als0052/py-PiPrinter/all_the_pi/Documents/Images/board_wiring_3.jpg

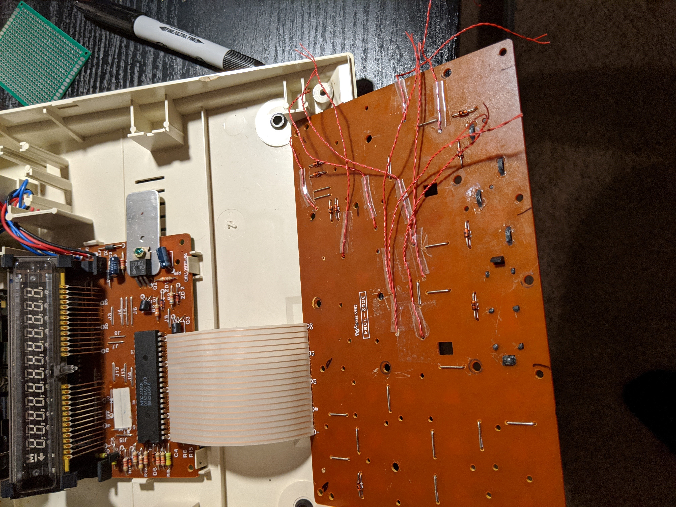
all_the_pi/Documents/Images/board_wiring_3.jpg
