als0052/py-PiPrinter/all_the_pi/Documents/Electrical/mmc_hardware_parts.txt

McMaster Carr
https://www.mcmaster.com/95185A110
https://www.mcmaster.com/93505A101

Amazon
https://www.amazon.com/Hakko-FX888D29BY-ESD-Safe-Digital-Soldering/dp/B00OSM27T8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
https://www.amazon.com/QuadHands-Helping-Hands-Third-Soldering/dp/B00GIKVP5K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
https://www.amazon.com/MAIYUM-63-37-Solder-Electrical-Soldering/dp/B076QF1Y85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

https://www.amazon.com/Adding-Machine-Calculator-White-UNV35715/dp/B0002A5AVM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
https://www.amazon.com/Compatible-Nukote-Calculator-Ribbon-6-pack/dp/B0057KY2Y8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
