als0052/py-PiPrinter/all_the_pi/Documents/Electrical/keyboard_IC_pinouts.xlsx

Sheet: Sheet1
pin | Pin symbol | port
1 | RESET | reset
2 | CL1 | CLOCK PIN 1
3 | CL2 | CLOCK PIN 2
4 | V_pre | high voltage predriver supply
5 | V_LOAD | high voltage optin resistor supply 7527A/28A only
6 | P5_0 | high voltage i/o port 5_0
7 | P5_1 | high voltage i/o port 5_1
8 | P5_2 | high voltage i/o port 5_2
9 | P5_3 | high voltage i/o port 5_3
10 | P2_3 | high voltage output port 2_3 and output port from timer/event counter (ptout)
11 | P2_2 | high voltage output port 2_2 and output port from timer/event counter (ptout)
12 | P2_1/PTOUT | high voltage output port 2_1 and output port from timer/event counter (ptout)
13 | P0_0 | high current high voltage i/o port 0_0
14 | P0_1 | high current high voltage i/o port 0_1
15 | P0_2 | high current high voltage i/o port 0_2
16 | P0_3 | high current high voltage i/o port 0_3
17 | P1_0 | high current high voltage i/o port 1_0
18 | P1_1 | high current high voltage i/o port 1_1
19 | P1_2 | high current high voltage i/o port 1_2
20 | P1_3 | high current high voltage i/o port 1_3
21 | V_DD | positive power supply
22 | P9_0 | high voltage high-current output port 9_0
23 | P9_1 | high voltage high-current output port 9_1
24 | P9_2 | high voltage high-current output port 9_2
25 | P9_3 | high voltage high-current output port 9_3
26 | P8_0 | high voltage high current output port 8_0
27 | P8_1 | high voltage high current output port 8_1
28 | P8_2 | high voltage high current output port 8_2
29 | P8_3 | high voltage high current output port 8_3
30 | P4_0 | high voltage i/o port 4_0
31 | P4_1 | high voltage i/o port 4_1
32 | P4_2 | high voltage i/o port 4_2
33 | P4_3 | high voltage i/o port 4_3
34 | P3_0 | high voltage output port 3_0
35 | P3_1 | high voltage output port 3_1
36 | P3_2 | high voltage output port 3_2
37 | P3_3 | high voltage output port 3_3
38 | P0_3/SI | 4 bit input of port 0; or serial data input (SI), serial data output (SO), serial clock 1/0 (SCK), and external interrupt input (INTO) or zero-cross detect input (PO_o)
39 | P0_2/SO | 4 bit input of port 0; or serial data input (SI), serial data output (SO), serial clock 1/0 (SCK), and external interrupt input (INTO) or zero-cross detect input (PO_o)
40 | P0_1/SCK | 4 bit input of port 0; or serial data input (SI), serial data output (SO), serial clock 1/0 (SCK), and external interrupt input (INTO) or zero-cross detect input (PO_o)
41 | P0_0/INTO | 4 bit input of port 0; or serial data input (SI), serial data output (SO), serial clock 1/0 (SCK), and external interrupt input (INTO) or zero-cross detect input (PO_o)
42 | V_SS | Ground

Sheet: Sheet2
Port Name | Description
RESET | system reset (input)
CL1, CL2 | connection to RC oscillator. CL1 is the external clock input
V_PRE | negative power supply for high-voltage output pre-drivers (ports 2-5, 8-11)
V_LOAD | negative power supply for optional load desistors (pull-down resistors) of high voltage output drivers (ports 2-5, 8-11). This pin is only on the PD7527A/28A
P5_3-P5_0 | 4-bit high voltage I/O port 5
P2_1-P2_3 | 3-bit high voltage output port 2
PTOUT | Output port from the timer/event counter
P10_3-P10_0 | 4-bit, high voltage, high-current I/O port 10. Capable of bit set/reset by SPBL/RPBL instructions
P11_3-P11_0 | 4-bit, high voltage, high-current I/O port 11. Capable of bit set/reset by SPBL/RPBL instructions
V_DD | positive power supply
P9_3-P9_0 | 4-bit high voltage high current output port 9. Capable of bit set/reset by SPBL/RPBL instructions.
P8_3-P8_0 | 4-bit high voltage high current output port 8. Capable of bit set/reset by SPBL/RPBL instructions.
P4_3-P4_0 | 4-bit high voltage I/O port 4
P3_3-P3_0 | 4-bit high voltage I/O port 3
P0_3-P0_0 | 4-bit input port 0. P0_0 is also used as the zero-cross detection input.
SI | serial data input
SO | serial data output
SCK | I/O serial clock
INT0 | external interrupt input
V_SS | ground
