als0052/py-PiPrinter/all_the_pi/Documents/Electrical/schemeit-project.png

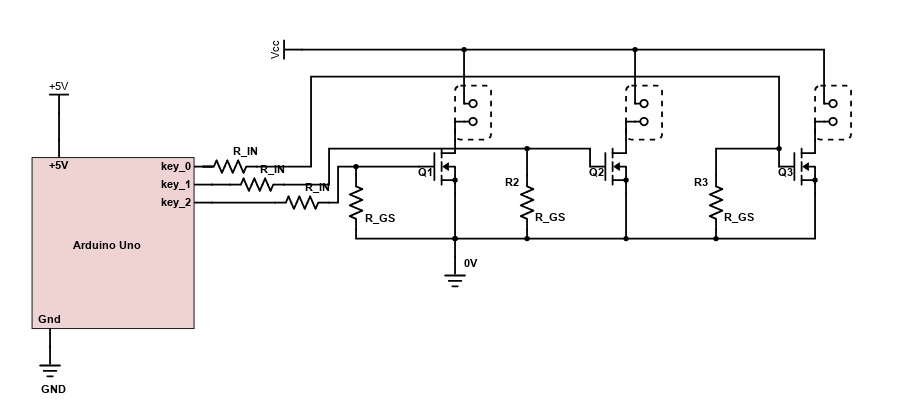
all_the_pi/Documents/Electrical/schemeit-project.png
