als0052/py-PiPrinter/all_the_pi/Documents/powerpoint_is_useful.png

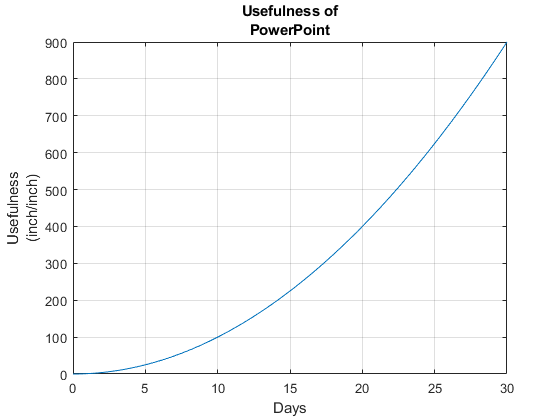
all_the_pi/Documents/powerpoint_is_useful.png
