als0052/py-PiPrinter/all_the_pi/Documents/Electrical/Master BOM.xlsx

Sheet: Summary
 | Total | $114.91
id | Vendor | Subtotal
1 | Digikey | $33.58
2 | McMaster Carr | $21.79
3 | Amazon | $59.54
4
5
6
7
8
9
10
11
12
13
14
15
16
17
18
19
20
21
22
23
24
25

Sheet: Digikey
Index | Quantity | Part Number | Manufacturer Part Number | Description | Customer Reference | Available | Backorder | Unit Price | Extended Price USD
1 | 10 | ED10503-ND | 101-206 | CONN SOCKET 20POS IDC GOLD |  | 10 | 0 | $0.41 | $4.13
2 | 10 | ED10524-ND | 302-S201 | CONN HEADER VERT 20POS 2.54MM |  | 10 | 0 | $0.45 | $4.48
3 | 0 | 2057-PH2-20-UA-ND | PH2-20-UA | CONN HEADER VERT 20POS 2.54MM |  | 10 | 0 | $0.25 | $0.00
4 | 0 | WM19417-ND | 14441202 | CONN PLUG 2POS IDC 24AWG GOLD |  | 10 | 0 | $0.66 | $0.00
5 | 2 | 2183-4000-ND | 4000 | POLOLU 400-POINT BREADBOARD WITH |  | 5 | 0 | $2.55 | $5.10
6 | 0 | ED10565-ND | OSTVN06A150 | TERM BLK 6P SIDE ENT 2.54MM PCB |  | 1 | 0 | $1.77 | $0.00
7 | 0 | ED10567-ND | OSTVN10A150 | TERM BLK 10P SIDE ENT 2.54MM PCB |  | 1 | 0 | $2.95 | $0.00
8 | 0 | ED10566-ND | OSTVN08A150 | TERM BLK 8P SIDE ENT 2.54MM PCB |  | 2 | 0 | $2.36 | $0.00
9 | 0 | 952-1902-ND | M20-9992046 | CONN HEADER VERT 20POS 2.54MM |  | 20 | 0 | $0.59 | $0.00
10 | 0 | DW-10-07-G-S-200-ND | DW-10-07-G-S-200 | CONN HDR 10POS 0.1 STACK T/H |  | 4 | 0 | $1.24 | $0.00
11 | 2 | CP3-1000-ND | PP3-002A | CONN PWR PLUG 2.1X5.5MM SOLDER |  | 2 | 0 | $1.29 | $2.58
12 | 0 | K229-ND | R-30B-0050 | WIRE WW 30AWG PVDF BLUE 50' |  | 1 | 0 | $10.50 | $0.00
13 | 0 | K231-ND | R-30W-0050 | WIRE WW 30AWG PVDF WHITE 50' |  | 1 | 0 | $10.50 | $0.00
14 | 0 | K232-ND | R-30R-0050 | WIRE WW 30AWG PVDF RED 50' |  | 1 | 0 | $10.50 | $0.00
15 | 0 | K230-ND | R-30Y-0050 | WIRE WW 30AWG PVDF YELLOW 50' |  | 1 | 0 | $10.50 | $0.00
16 | 0 | K397-ND | R30W-0100 | WIRE WW 30AWG PVDF WHITE 100' |  | 1 | 0 | $13.40 | $0.00
17 | 0 | K394-ND | R30BLK-0100 | WIRE WW 30AWG PVDF BLACK 100' |  | 1 | 0 | $13.40 | $0.00
18 | 0 | C503B-RAN-CZ0C0AA1-ND | C503B-RAN-CZ0C0AA1 | LED RED CLEAR 5MM ROUND T/H |  | 1 | 0 | $0.15 | $0.00
19 | 1 | HDM24H-ND | AWLP 24/3,2-G | CONN DIP HDR IDC 24POS VERT |  | 1 | 0 | $1.35 | $1.35
20 | 1 | WM9685-ND | 873690400 | CONN RCPT HSG 4POS 2.00MM |  | 1 | 0 | $0.10 | $0.10
21 | 100 | WM4561CT-ND | 502128000 | CONN SOCKET 24-30AWG CRIMP TIN |  | 100 | 0 | $0.04 | $4.15
22 | 1 | WM13310-ND | 894010410 | CONN HEADER R/A 4POS 2MM |  | 1 | 0 | $0.16 | $0.16
23 | 10 | A1922-ND | 640456-4 | CONN HEADER VERT 4POS 2.54MM |  | 10 | 0 | $0.21 | $2.14
24 | 10 | A30980-ND | 3-640441-4 | CONN RCPT 4POS IDC 24AWG TIN |  | 10 | 0 | $0.20 | $2.02
25 | 100 | A24745CT-ND | 42068 | CONN QC RCPT 18-22AWG 0.110 |  | 100 | 0 | $0.06 | $5.88
26 | 1 | EG4539-ND | MS0850501F025C1A | SWITCH SNAP ACTION SPDT 5A 125V |  | 1 | 0 | $1.49 | $1.49

Sheet: MMC
id | Order Qty | Qty/order | P/N | Description | Price | Cost | Link
1 | 1 | 50 | 95185A110 | Zinc-Plated Steel Press-Fit Nut for Sheet Metal 4-40 Thread Size, for 0.03" Minimum Panel Thickness | $10.60 | $10.60 | link (https://www.mcmaster.com/95185A110)
2 | 10 | 1 | 93505A101 | Male-Female Threaded Hex Standoff Aluminum, 3/16" Hex Size, 1/4" Long, 4-40 Thread Size | $0.36 | $3.60 | link (https://www.mcmaster.com/93505A101)
3 | 0 | 100 | 94639A703 | Off-White Nylon Unthreaded Spacer 3/16" OD, 3/16" Long, for Number 2 Screw Size | $9.24 | $0.00 | link (https://www.mcmaster.com/94639a703)
4 | 0 | 50 | 91831A002 | 18-8 Stainless Steel Nylon-Insert Locknut 2-56 Thread Size | $3.95 | $0.00 | link (https://www.mcmaster.com/91831a002)
5 | 0 | 25 | 96439A130 | 18-8 Stainless Steel Press-Fit Nut for Sheet Metal 2-56 Thread Size, for 0.025" Minimum Panel Thickness | $8.02 | $0.00 | link (https://www.mcmaster.com/96439a130)
6 | 0 | 100 | 90480A003 | Low-Strength Steel Hex Nut Zinc-Plated, 2-56 Thread Size | $1.00 | $0.00 | link (https://www.mcmaster.com/90480A003)
7 | 0 | 50 | 91251A055 | Black-Oxide Alloy Steel Socket Head Screw 0-80 Thread Size, 1/4" Long | $3.54 | $0.00 | LINK (https://www.mcmaster.com/91251a055)
8 | 0 | 100 | 90480A001 | Low-Strength Steel Hex Nut Zinc-Plated, 0-80 Thread Size | $5.02 | $0.00 | link (https://www.mcmaster.com/90480A001)
9 | 0 | 1 | 6338K564 | Oil-Embedded Flanged Sleeve Bearing for 3/16" Shaft Diameter and 5/16" Housing ID, 3/8" Long | $0.70 | $0.00 | link (https://www.mcmaster.com/6338k564)
10 | 0 | 1 | 1327K105 | Rotary Shaft 12L14 Carbon Steel, 3/16" Diameter, 5" Long | $4.56 | $0.00 | link (https://www.mcmaster.com/1327k105)
11 | 1 | 100 | 91737A069 | Narrow Fillister Head Phillips Screws High-Profile, 4-40 Thread, 3/16" Long | $4.22 | $4.22 | link (https://www.mcmaster.com/91737a069)
12 | 1 | 100 | 90730A005 | 18-8 Stainless Steel Narrow Hex Nut 4-40 Thread Size | $3.37 | $3.37 | link (https://www.mcmaster.com/90730a005)
13
14
15
16
17
18
19
20
21
22
23
24
25

Sheet: Amazon
id | Order Qty | Qty/order | P/N | Description | Price | Cost | Link
1 | 0 | 1 | FX888D-29BY/P | Hakko FX888D29BY/P ESD-Safe Digital Soldering Station w/ FX8801 Soldering Iron and T18D16 Tip (Gold) | $104.95 | $0.00 | link (https://www.amazon.com/Hakko-FX888D29BY-ESD-Safe-Digital-Soldering/dp/B00OSM27T8)
2 | 0 | 1 |  | QuadHands Helping Hands Soldering Third Hand Tool | 4 Flexible Metal Arms Are Easy to Position | Rotating Stainless Steel Clamps | Made in USA - Professional Grade | $39.95 | $0.00 | link (https://www.amazon.com/QuadHands-Helping-Hands-Third-Soldering/dp/B00GIKVP5K)
3 | 1 | 1 |  | MAIYUM 63-37 Tin Lead Rosin core solder wire for electrical soldering (0.6mm 100g) | $9.59 | $9.59 | link (https://www.amazon.com/gp/product/B076QD1W9X/ref=ox_sc_act_title_2?smid=A25N4YN27ERTBB&psc=1)
4 | 0 | 12 |  | Adding Machine/Calculator Roll, 2-1/4"x150 ft White 12/Pack, UNV35715 | $10.99 | $0.00 | link (https://www.amazon.com/Adding-Machine-Calculator-White-UNV35715/dp/B0002A5AVM)
5 | 0 | 6 |  | New Compatible Nukote BR80C Calculator Ribbon Black/Red (6-pack) For Sharp El 1197 P III | $7.01 | $0.00 | link (https://www.amazon.com/Compatible-Nukote-Calculator-Ribbon-6-pack/dp/B0057KY2Y8)
6 | 0 | 1280 | An-resistor01 | 1280 Pieces 64 Values Resistor Kit, 1% Assorted Resistors 1 Ohm-10M Ohm 1/4W Metal Film Resistors Assortment with Storage Box for DIY Projects and Experiments | $13.99 | $0.00 | link (https://www.amazon.com/Resistor-Assorted-Resistors-Assortment-Experiments/dp/B07L851T3V)
7 | 1 | 5 |  | HiLetgo 5pcs Micro SD TF Card Adater Reader Module 6Pin SPI Interface Driver Module with chip Level Conversion for Arduino UNO R3 MEGA 2560 Due | $6.99 | $6.99 | link (https://www.amazon.com/gp/product/B07BJ2P6X6/ref=ox_sc_saved_title_1?smid=A30QSGOJR8LMXA&psc=1)
8 | 1 | 1 |  | SanDisk Ultra 32GB MicroSDHC UHS-I Card with Adapter - 98MB/s U1 A1 - SDSQUAR-032G-GN6MA | $7.99 | $7.99 | link (https://www.amazon.com/gp/product/B073JWXGNT/ref=ox_sc_saved_title_2?smid=ATVPDKIKX0DER&psc=1)
9 | 2 | 10 |  | BOJACK RFP30N06LE MOSFET 30 A 60 V RFP30N06LE N-Channel Power MOSFET Transistor ESD Rated TO-220 (Pack of 10 Pcs) | $7.99 | $15.98 | link (https://www.amazon.com/BOJACK-RFP30N06LE-MOSFET-N-Channel-Transistor/dp/B07WR86ZGS)
10 | 1 | 1 |  | DOWELL Wire Stripper with Cutter Wire Stripping Tool 10-24AWG for Flat Ribbon Cable Wire Electrical Automotive Repair | $9.99 | $9.99 | link (https://www.amazon.com/gp/product/B07HF2SGHX/ref=ox_sc_act_title_7?smid=ATB7GMXHTWNOH&psc=1)
11 | 1 | 1 |  | KNACRO Arduino Compatible Prototyping Board PCB Bare Board Universal Extension Boardproto Screw Shield | $9.00 | $9.00 | link (https://www.amazon.com/KNACRO-compatible-Prototyping-Universal-Boardproto/dp/B0716NB1VS)
12
13
14
15
16
17
18
19
20
21
22
23
24
25
