als0052/py-PiPrinter/all_the_pi/Documents/SCAD/PaperSpoolMaker.3mf

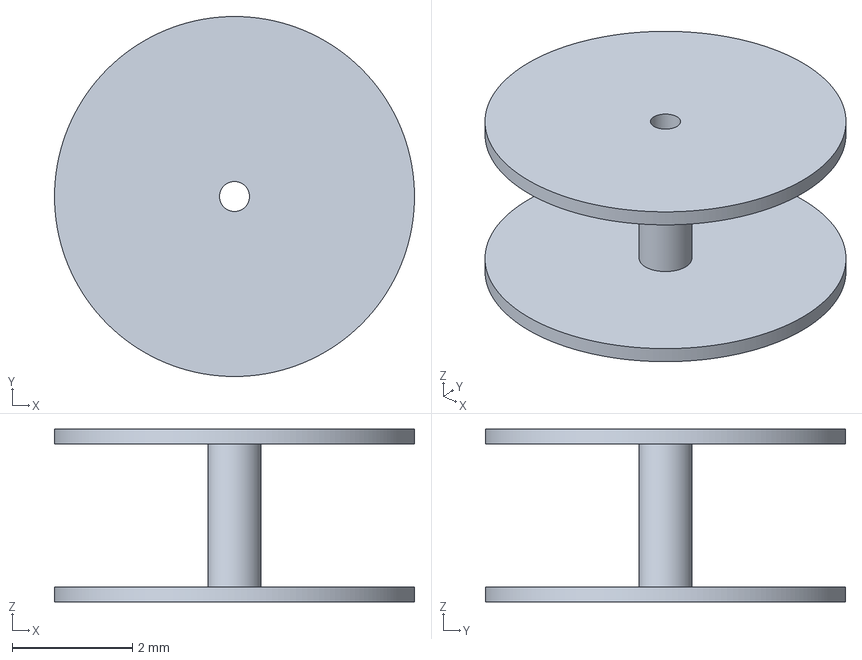
[picture p5: CAD file, 2021-02-16]
all_the_pi/Documents/SCAD/PaperSpoolMaker.3mf
6.00 x 6.00 x 2.88 mm
