als0052/py-PiPrinter/all_the_pi/Documents/Electrical/PiPrinter_Rev9.pdf

U1

## SD Card Module

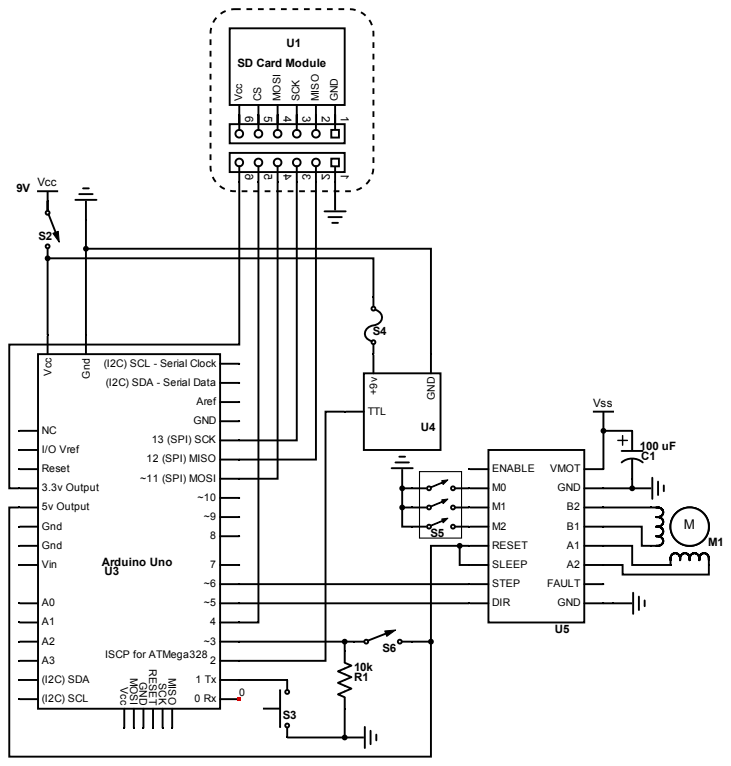
[picture p6: page 1]
Vcc; OSI; SCK; MISO; GND; Vcc 9V; Vss; VMOT; FAULT; ENABLE; RESET; SLEEP; STEP; DIR; TTL; ISCP for ATMega328; Gnd; I/O Vref; Reset; 3.3v Output; 5v Output; Vin; (I2C) SDA; (I2C) SCL; Aref; 13 (SPI) SCK; 12 (SPI) MISO; ~11 (SPI) MOSI; MISO SCK; M OSI Vcc; Arduino Uno U3

(I2C) SCL - Serial Clock
(I2C) SDA - Serial Data

M

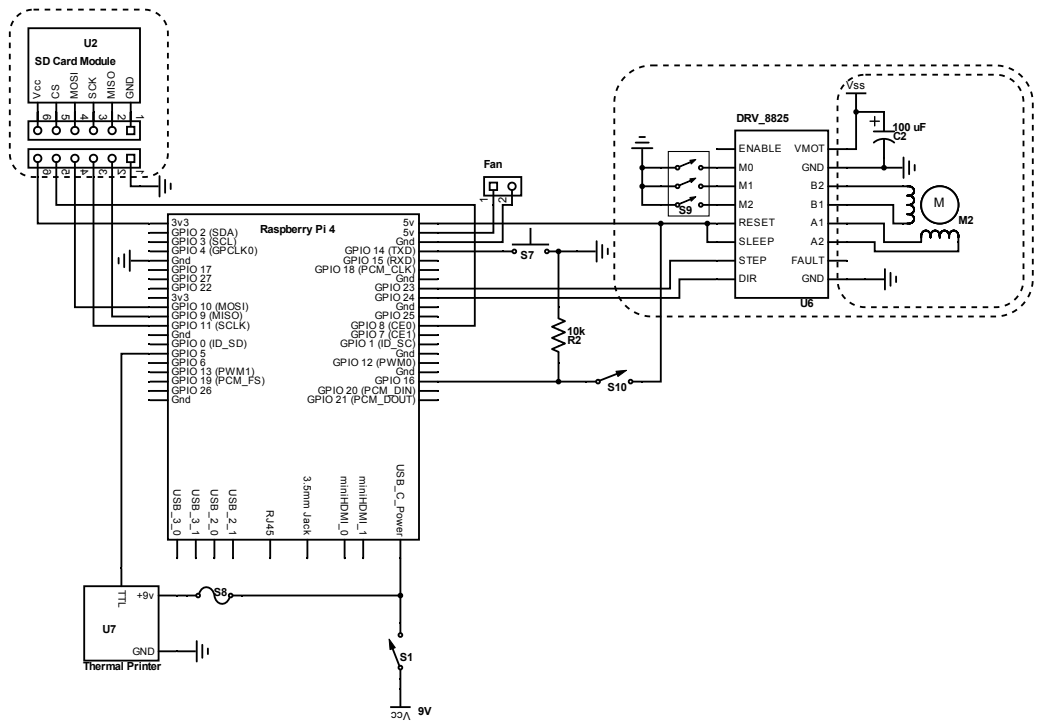
[picture p7: page 2]
Vss; VMOT; GND; FAULT; ENABLE; RESET; SLEEP; STEP; DIR; DRV_8825; Vcc; MOSI; SCK; MISO; TTL; Thermal Printer; GPIO 2 (SDA); GPIO 3 (SCL); Gnd; GPIO 4 (GPCLK0); GPIO 14 (TXD); GPIO 15 (RXD); GPIO 17; GPIO 18 (PCM_CLK); GPIO 27; GPIO 22; GPIO 23; GPIO 24; GPIO 10 (MOSI); GPIO 9 (MISO); GPIO 25; GPIO 11 (SCLK); GPIO 8 (CE0); GPIO 7 (CE1); GPIO 0 (ID_SD); GPIO 1 (ID_SC); GPIO 5; GPIO 6; GPIO 12 (PWM0); GPIO 13 (PWM1); GPIO 19 (PCM_FS); GPIO 16; GPIO 26; GPIO 20 (PCM_DIN); GPIO 21 (PCM_DOUT)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

SD Card Module
