als0052/py-PiPrinter/all_the_pi/Documents/Images/board_wiring_1.jpg

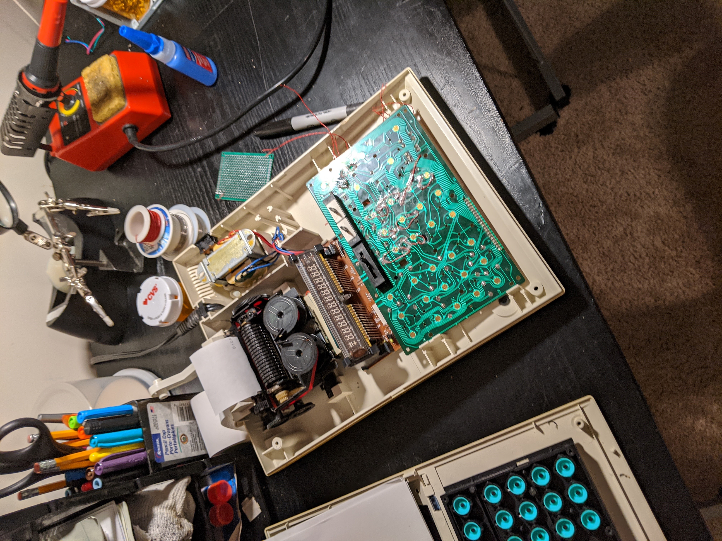
all_the_pi/Documents/Images/board_wiring_1.jpg
